landonmaynard/nighthawk/docs/BUDGET.md

# Budget & Funding

## Overview

Nighthawk is an independent engineering project that I'm developing and funding myself. I've already invested my own time, money, and equipment into its design, simulations, and electronics development.

As a high school student, covering the remaining costs on my own is difficult. I'm seeking support to continue the project and get real experience with mechanical design, electronics, and software.

My goal is to have funding by **December 31, 2026**, so it will be possible to complete by **Spring 2027**

## Funding Goal

**Target: $800**

| Funding Status | Amount |
|---|---:|
| Funding Goal | $800.00 |
| Contributions Received | $800.00 |
| Remaining Goal | $0.00 |
| Progress | 100% |

**FUNDED!**

## Cost Breakdown

My current bill of materials includes the following estimated costs:

| Category | Estimated Cost |
|---|---:|
| Airframe & Structure | $148.69 |
| Propulsion & Retention | $189.06 |
| Recovery & Rigging | $88.66 |
| Avionics & Telemetry | $154.90 |
| Consumables | $84.60 |
| Taxes & Shipping | $145.85 |
| **Total Estimated Cost** | **$811.76** |

These figures include approximately **$180.48 in equipment I have already bought**, leaving $631.28 in currently listed expenses.

My $800 funding goal provides some flexibility for changing prices, unexpected expenses, and further engineering development.

### Detailed Bill of Materials

The complete spreadsheet contains individual components, quantities, estimated prices, suppliers, and shipping costs.

**[View the Nighthawk Bill of Materials](BOM.xlsx)**

The spreadsheet includes two sheets:

- **BOM:** Itemized components, quantities, and estimated costs.
- **Shipping:** Supplier-specific shipping estimates and supporting information.

Prices and product selections can change, and I'll keep the spreadsheet updated as the project progresses.

## Sponsorship & Support

With permission, I'd like to recognize sponsors in this repository, including the main README and this budget. Also, on individual cases I can put a logo on the final rocket. Contributions of any size are greatly appreciated.

### Sponsors

- **$400 - Vern Knowles and Multitronix**
- **$250 - Dmitriy Yavid**
- **$100 - Aaron Clarke and Embedded Systems Consulting**
- **$50 - Robert Yarbrough**
- **Richard Grimmett** — Avionics sensors
- **[b2 Rocketry Co.](https://b2rocketry.com)** — Recovery parachute

## Additional Funding

I'm striving to make the most out of every dollar donated, putting it towards materials and electronics, with no funding towards any work I do.

I'll continue to update this and the main page as changes are made, and the current total.

---

*Last updated: November 10 2026*
