landonmaynard/nighthawk/cad/ONSHAPE.md

https://cad.onshape.com/documents/133a6bdae2082b7afaaeb0c3/w/fbf40f275b5edf98284b4e3f/e/2c8e62942e56a1cf9c46fe07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
