landonmaynard/nighthawk/media/images/imu-demo.jpg

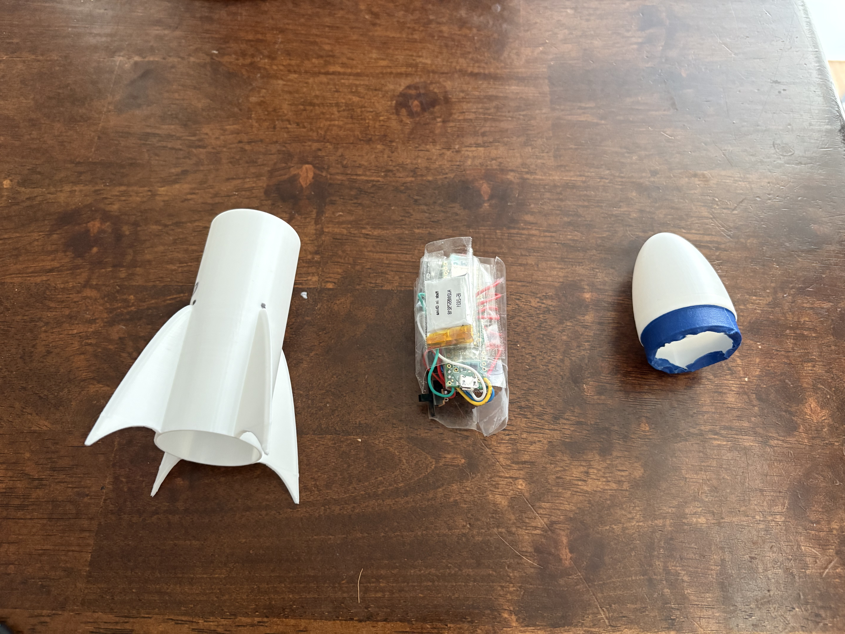
media/images/imu-demo.jpg
