landonmaynard/nighthawk/media/images/imu-progress.jpg

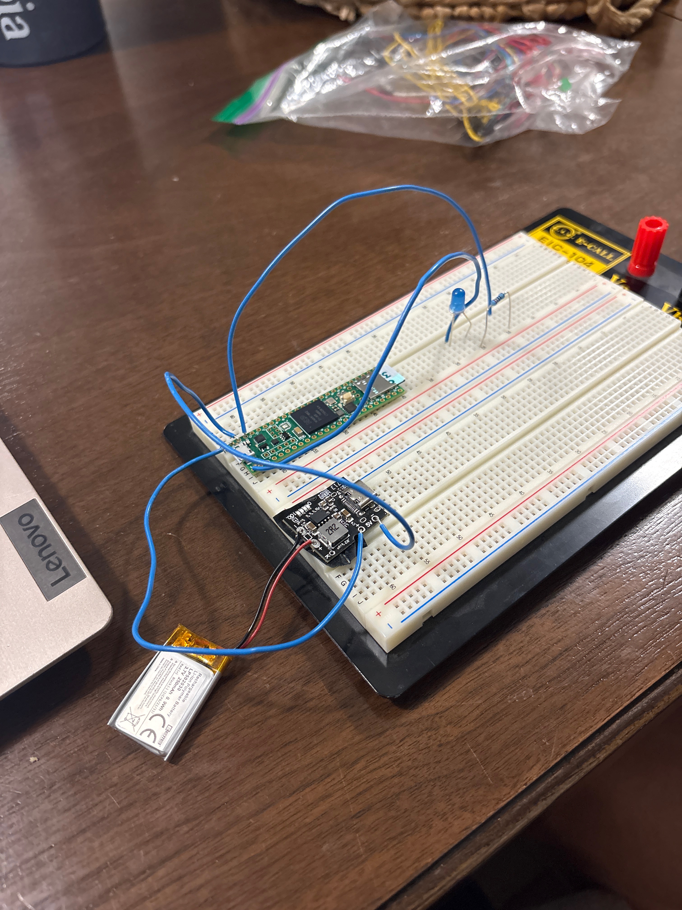
media/images/imu-progress.jpg
