landonmaynard/nighthawk/docs/BOM.xlsx

Sheet: BOM
Item | Subsystem | Part / Specification | Supplier | Purchase Qty | Unit Cost $ | Total Cost $ | Build / Ownership | Source / Selection Status
Booster Blue Tube | Airframe & Structure | 3" (75mm) x .062 wall x 48" Airframe | Always Ready Rocketry | 1 | 36.96 | 36.96 | Commercial | https://alwaysreadyrocketry.com/product/1-15-29mm-x-062-wall-x-48-airframe-mmt/
e-Bay Blue Tube | Airframe & Structure | 3" (75mm) x .062 wall x 24" MMT | Always Ready Rocketry | 1 | 20.48 | 20.48 | Commercial | https://alwaysreadyrocketry.com/product/1-15-29mm-x-062-wall-x-48-airframe-mmt/
AeroTech Motor | Propulsion & Retention | AeroTech I500T-14A 38mm x 356mm Single Use DMS 1-Motor Kit - 095014; already purchased, no new shipping | AeroTech | 1 | 129.99 | 129.99 | Owned; grant value retained | https://aerotech-rocketry.com/products/product_b8bb226e-67ff-3fc3-2803-c4bade36e0b8
Fin Stock | Airframe & Structure | LOC 18PLY: 1/8 in. 3-ply Baltic birch, 6 x 12 in. sheets; four sheets equal original 12 x 24 in. area. PROVISIONAL: each complete fin/tab must fit one sheet; confirm cutting layout before purchase. | LOC Precision | 4 | 5.62 | 22.48 | Cut / TTW fins | https://locprecision.com/products/loc-plywood?variant=39778639413439
Nose Cone | Airframe & Structure | LOC PNC-3.00, 3.0 in. (75mm) plastic nose cone; verify shoulder fit before ordering | LOC Precision | 1 | 24.47 | 24.47 | Commercial | https://locprecision.com/products/nose-cones?variant=39778657304767
Blue Tube Coupler | Airframe & Structure | 3" (75mm) x .062 wall x 8" | Always Ready Rocketry | 1 | 9.00 | 9.00 | Commercial | https://alwaysreadyrocketry.com/product/1-15-29mm-x-062-wall-x-8-coupler/
Centering Ring / Bulkhead Baltic Birch | Airframe & Structure | LOC 25PLY: 1/4 in. 5-ply Baltic birch, 6 x 12 in. sheets. Two sheets for SIX ring/bulkhead pieces TOTAL, including stepped bulkheads; confirm final cutting layout, kerf and measured tube fits before purchase. | LOC Precision | 2 | 8.37 | 16.74 | Cut rings / bulkheads | https://locprecision.com/products/loc-plywood?variant=39778639380671
Rail Buttons Set | Airframe & Structure | AeroPack standard 1010 Delrin rail button pair, Apogee #13060; mounting screws included | Apogee Components | 1 | 5.58 | 5.58 | Commercial | https://www.apogeerockets.com/Building_Supplies/Rail_Buttons/1in_1010_Rail_Button_Standard
Motor Mount Tube | Propulsion & Retention | 1.52" (38mm) x .062 wall x 16" MMT | Always Ready Rocketry | 1 | 7.95 | 7.95 | Commercial | https://alwaysreadyrocketry.com/product/1-15-29mm-x-062-wall-x-48-airframe-mmt/
Motor Retainer | Propulsion & Retention | AeroPack RA38L 38mm L threaded retainer set, Apogee #24062; 1.630 in. ID for Blue Tube mount; verify actual tube OD | Apogee Components | 1 | 30.63 | 30.63 | Commercial | https://www.apogeerockets.com/Building_Supplies/Motor_Retainers_Hooks/Screw-on_Retainers_38mm/38mm_AeroPack_Retainer_L
Delay Drilling Tool | Propulsion & Retention | AeroTech DMS Universal Delay Drilling Tool - UDDT | AeroTech | 1 | 20.49 | 20.49 | Commercial | https://aerotech-rocketry.com/products/product_d208be9f-32da-778d-77e9-093c84bb0508
42" Parachute | Recovery & Rigging | LOC/PRECISION Parachutes LP-42 | LOC Precision | 1 | 34.81 | 34.81 | Commercial | https://locprecision.com/products/locprecision-parachutes?variant=39778658451647
Shock Cord | Recovery & Rigging | LOC TN-25: 25 ft x 5/8 in. tubular nylon, sewn end loops, published 2200 lb tensile rating; final recovery-load/attachment check pending | LOC Precision | 1 | 22.70 | 22.70 | Commercial | https://locprecision.com/products/shock-cords?variant=39778657665215
Flame Blanket | Recovery & Rigging | LOC/PRECISION Flame Resistant Blankets FRB-S | LOC Precision | 1 | 8.67 | 8.67 | Commercial | https://locprecision.com/products/locprecision-flame-resistant-blankets?variant=39778640494783
MMT Parachute Eye Bolts (2-pack) | Recovery & Rigging | 1/4 in.-20 x 2 in. Zinc Eye Bolt (2-Pack); quantity is packs purchased; recovery load suitability still requires review | Home Depot | 1 | 1.57 | 1.57 | Commercial | https://www.homedepot.com/p/Everbilt-1-4-in-20-x-2-in-Zinc-Eye-Bolt-2-Pack-824301/314745414
e-Bay Parachute Eye Nuts (2-pack) | Recovery & Rigging | 1/4" Round Lifting Eye Nut (2/pk); quantity is packs purchased | Apogee Components | 1 | 14.43 | 14.43 | Commercial | https://www.apogeerockets.com/Building-Supplies/Misc-Hardware/Round-Lifting-Eye-Nut-2-pk
Machine Screws (Nose Shoulder Mounting) | Recovery & Rigging | Hillman #4 - 40 x 1-in Phillips/Slotted combination -Drive Machine screws 10 -Count; quantity is 10-count packs purchased; quantity is 10-count packs purchased; quantity is 10-count packs purchased | Lowe's | 1 | 1.98 | 1.98 | Commercial | https://www.lowes.com/pd/Hillman-4-40-x-1-in-Phillips-Slotted-Combination-Drive-Machine-Screws-10-Count/3036647
Custom PCB | Avionics & Telemetry | ESTIMATE: 50 x 100 mm, 2-layer FR-4, 1.6 mm; fit TBD; $20 batch allowance includes shipping, not a quote | JLCPCB | 5 | 4.00 | 20.00 | Custom (Fab) | https://jlcpcb.com/help/article/how-do-i-place-an-order
Microcontroller | Avionics & Telemetry | Teensy 4.1; already purchased, no new shipping | SparkFun | 1 | 31.50 | 31.50 | Owned; grant value retained | https://www.sparkfun.com/teensy-4-1.html
6-DOF IMU | Avionics & Telemetry | Adafruit ISM330DHCX 6-DoF IMU breakout #4502 | Adafruit | 1 | 19.95 | 19.95 | Commercial | https://www.adafruit.com/product/4502
Barometer & Thermometer | Avionics & Telemetry | Adafruit BMP388 - Precision Barometric Pressure and Altimeter - STEMMA QT | Adafruit | 1 | 9.95 | 9.95 | Commercial | https://www.adafruit.com/product/3966
Magnetometer | Avionics & Telemetry | Adafruit LIS2MDL Triple-axis Magnetometer #4488 | Adafruit | 1 | 7.95 | 7.95 | Commercial | https://www.adafruit.com/product/4488
GPS | Avionics & Telemetry | NEO-6M GPS Module with antenna | ProtoSupplies | 1 | 10.95 | 10.95 | Commercial | https://protosupplies.com/product/neo-6m-gps-module/
ELRS Receiver | Avionics & Telemetry | RP1 V2 ExpressLRS 2.4ghz Nano Receiver; already purchased, no new shipping | RadioMaster | 1 | 18.99 | 18.99 | Owned; grant value retained | https://radiomasterrc.com/products/rp1-expresslrs-2-4ghz-nano-receiver
Voltage & Current Monitor | Avionics & Telemetry | INA219 DC Current Measurement Module (MOD-72) | ProtoSupplies | 1 | 2.59 | 2.59 | Commercial | https://protosupplies.com/product/ina219-dc-current-measurement-module/
Flight Battery | Avionics & Telemetry | BadAss 45C 1000mAh 2S LiPo (BA-L45C-1000-2S), XT30 | Innov8tive Designs | 1 | 11.99 | 11.99 | Commercial | https://innov8tivedesigns.com/badass-45c-1000mah-2s-lipo-battery.html
Voltage Regulator | Avionics & Telemetry | MPM3610 5V 1.2A Buck Converter Breakout #4739 | Adafruit | 1 | 6.95 | 6.95 | Commercial | https://www.adafruit.com/product/4739
Power Switch (2-pack) | Avionics & Telemetry | Miniature Toggle Switch DPDT ON-OFF-ON (SWT-11); one used, one spare | ProtoSupplies | 1 | 1.19 | 1.19 | Commercial | https://protosupplies.com/product/miniature-toggle-switch-dpdt/
Locator Alarm | Avionics & Telemetry | Large Piezo Alarm - 16 Tone (COM-13939) | SparkFun | 1 | 7.95 | 7.95 | Commercial | https://www.sparkfun.com/large-piezo-alarm-16-tone.html
Alarm Driver Transistor (10-pack) | Avionics & Telemetry | 2N3904 NPN TO-92 (XTR-4); one used, nine spare; resistors already owned | ProtoSupplies | 1 | 1.95 | 1.95 | Commercial | https://protosupplies.com/product/2n3904/
XT30 Connector Set | Avionics & Telemetry | XT30-2M-2F; two male and two female connectors | Innov8tive Designs | 1 | 2.99 | 2.99 | Commercial | https://innov8tivedesigns.com/xt30-connector-set-2-male-2-female.html
Structural Epoxy | Consumables | BSI Slow-Cure 30-minute epoxy, 9 oz combined resin and hardener (BSEPY-309 / BSI-206) | LOC Precision | 1 | 23.61 | 23.61 | Commercial | https://locprecision.com/products/epoxy?variant=39778639872191
PETG Filament | Consumables | BUDGET ONLY: 1 kg PETG, 1.75 mm, $20 allowance. Brand, seller and printer compatibility unselected; separate $8 shipping allowance retained. | Unselected supplier | 1 | 20.00 | 20.00 | Commercial | Not selected; budget allowance, not a product quote
Paint & Primer | Consumables | BUDGET ONLY: compatible primer and spray paint; $25 combined allowance. Planned local pickup; exact products, color and coverage not selected. | Home Depot | 1 | 25.00 | 25.00 | Commercial | Not selected; budget allowance, not a product quote
Recovery Quick Links | Recovery & Rigging | LOC CEC-2: 3/16 in. zinc quick link, published 660 lb rating; verify opening fit and final recovery loads | LOC Precision | 2 | 2.25 | 4.50 | Commercial | https://locprecision.com/products/chain-eye-connector?variant=39778639642815
E-Bay Threaded Rod | Airframe & Structure | Everbilt 1/4 in.-20 x 36 in. zinc-plated threaded rod #17320; cut two lengths, final length TBD | Home Depot | 1 | 2.98 | 2.98 | Commercial / cut to length | https://www.homedepot.com/p/100338099
Miscellaneous Bolts / Hardware | Airframe & Structure | BUDGET ONLY: $10 for assorted bolts, washers and nuts; planned local pickup; exact sizes and quantities depend on final assembly. | Home Depot | 1 | 10.00 | 10.00 | Commercial | Not selected; budget allowance, not a product quote
Tube Sanding Sealer | Consumables | ProLuxe 1 qt sanding sealer PLX015/04; Ace item 11268; listed oil-based alkyd lacquer; confirm Blue Tube and paint compatibility, local stock | Ace Hardware | 1 | 15.99 | 15.99 | Commercial | https://www.acehardware.com/p/11268
Estimated Sales Tax | Tax & Shipping | 6% budget allowance on listed item values, including already-owned grant values and bundled PCB allowance. Reconcile receipts; separate shipping excluded. | Idaho | 1 | 39.95 | 39.95 | Budget estimate | https://tax.idaho.gov/taxes/sales-use/online-guide/
Estimated Shipping | Tax & Shipping | ZIP 83274. Shipping tab distinguishes published rates, pickup assumptions and unquoted allowances; actual quotes remain pending. | Multiple suppliers | 1 | 105.90 | 105.90 | Budget estimate | See Shipping tab for supplier policies and quote status
BOM TOTAL | Budget Total | Includes owned-item grant values, 6% estimated tax and shipping budgets. Product choices retained; no purchase placed. | All listed suppliers | 1 | 811.76 | 811.76 | Calculated budget | Calculated from item, tax and shipping rows above

Sheet: Shipping
Supplier | New Order Subtotal $ | Shipping Budget $ | Basis / Outstanding Quote — ZIP 83274 — checked 2026-10-21 | Source
Always Ready Rocketry | 74.39 | 24.95 | PUBLISHED BASE ESTIMATE: $58.01-$120 order tier; three tubes and one coupler total $74.39. 48-inch tube sets box length. Boxed weight/size may increase final charge; request seller invoice. | https://alwaysreadyrocketry.com/shipping/
AeroTech | 20.49 | 10.00 | UNQUOTED allowance retained: UDDT tool only ($20.49). I500T already owned; no new motor freight or hazmat. Tool page calculates shipping at checkout; no public rate found. | https://aerotech-rocketry.com/products/product_d208be9f-32da-778d-77e9-093c84bb0508
Apogee Components | 50.64 | 12.00 | UNQUOTED allowance retained: rail buttons, RA38L retainer and eye-nut pack. Cart estimates packaging and may be revised after packing; no fixed public rate found. | https://www.apogeerockets.com/Shipping_Info
LOC Precision | 157.98 | 15.00 | UNQUOTED allowance retained: six plywood sheets total (4 thin + 2 thick), nose cone, parachute, harness, blanket, epoxy and two quick links. Ships USPS/UPS; checkout/packed-box quote required. | https://locprecision.com/policies/shipping-policy
SparkFun | 7.95 | 8.00 | UNQUOTED allowance retained: COM-13939 alarm only ($7.95). Teensy owned, excluded from new-order subtotal. Below $100 qualifying free-shipping threshold; cart quote required. | https://www.sparkfun.com/support
Adafruit | 44.80 | 10.00 | UNQUOTED allowance retained: ISM330DHCX, BMP388, LIS2MDL and MPM3610, $44.80 combined. USPS Ground Advantage allowed below $200; price requires cart/address. No batteries in this order. | https://www.adafruit.com/shipping
ProtoSupplies | 16.68 | 7.95 | PUBLISHED RATE: USPS Ground Advantage $7.95 for orders under $175; this order $16.68. Shipping page takes precedence over FAQ still showing $6.95. Not a checkout quote. | https://protosupplies.com/shipping-and-returns/
Innov8tive Designs | 14.98 | 10.00 | UNQUOTED allowance retained: 1000mAh 2S LiPo + XT30 set, $14.98. Public First Class Parcel flat rate $6.99 is not confirmed for a standalone LiPo order; retain $10 until battery-eligible cart service is quoted. | https://innov8tivedesigns.com/about-us/shipping-information.html
Unselected supplier | 20.00 | 8.00 | UNQUOTED allowance retained: PETG seller not selected. $20 material plus $8 delivery budget; cannot quote shipping until product/seller selected. | Not applicable; PETG supplier not selected
Home Depot | 39.55 | 0.00 | PICKUP ASSUMPTION: eye-bolt pack, threaded rod, $25 paint/primer allowance and $10 miscellaneous hardware allowance. Eligible store pickup is free; exact local stock and unselected products not verified. | https://www.homedepot.com/c/pick_up_in_store
Lowe's | 1.98 | 0.00 | PICKUP ASSUMPTION: one 10-count screw pack. Store pickup has no added charge when eligible; selected-store stock not verified. | https://www.lowes.com/l/help/store-pickup
Ace Hardware | 15.99 | 0.00 | PICKUP ASSUMPTION: ProLuxe sanding sealer. Free store pickup/warehouse-to-store where eligible; availability of this specific sealer locally not verified. | https://www.acehardware.com/customer-service-center/pickup-delivery-shipping
RadioMaster | 0.00 | 0.00 | ALREADY OWNED: RP1 receiver value stays in grant BOM; no new order or shipping. Ranger Micro remains excluded as requested. | https://radiomasterrc.com/products/rp1-expresslrs-2-4ghz-nano-receiver
JLCPCB | 20.00 | 0.00 | INCLUDED IN ALLOWANCE: $20 PCB batch budget already includes shipping; zero here prevents double counting. Not free shipping. Board design, weight, service, import charges and final checkout total still unquoted. | https://jlcpcb.com/help/article/how-much-does-shipping-cost
Total | 485.43 | 105.90 | Published rate/base estimates plus UNQUOTED allowances. No checkout shipping quotes obtained: remote browser blocked store access. Taxes excluded here. | Sources above; selected products and quantities are on BOM tab
