landonmaynard/nighthawk/cad/nighthawk.step

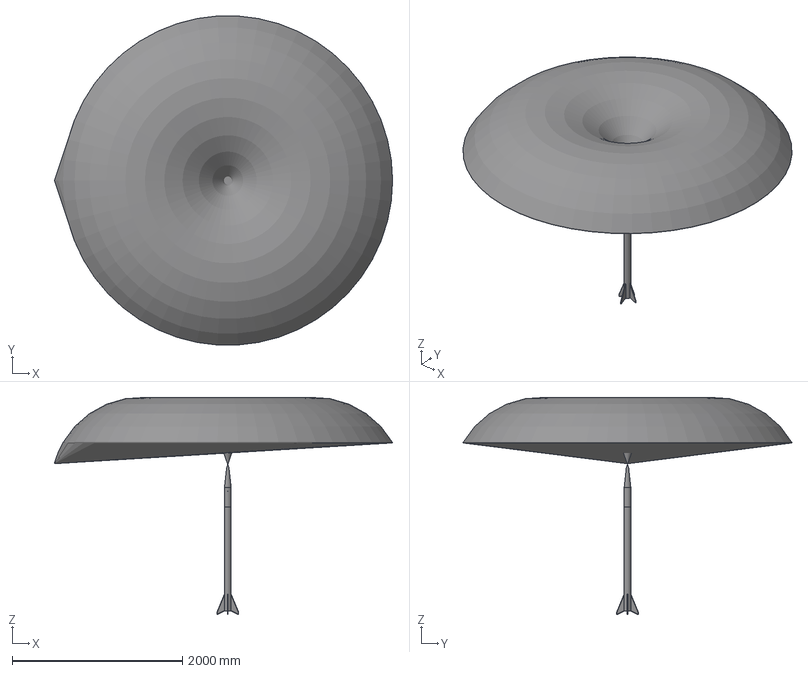
[picture p5: CAD file, 2026-10-31]
cad/nighthawk.step
3968.4 x 3859.9 x 2548.0 mm
HW-661 v4 x 38
BT eBay
Adafruit_ISM330DHXC.step-1/C_0805_2012Metric.step-2/SOLID.step-1-soli d1
Fin B
Adafruit_ISM330DHXC.step-1/SM04B-SRSS-TB(LF)(SN)--3DModel-STEP-56544. step-2/COMPOUND.step-1-solid2
Fin A
Adafruit_ISM330DHXC.step-1/QFN_DHCXTR_STM.step-1/COMPOUND-1.step-1-so lid4
Adafruit_ISM330DHXC.step-1/QFN_DHCXTR_STM.step-1/COMPOUND-1.step-1-so lid2
Fin C
Adafruit_ISM330DHXC.step-1/SM04B-SRSS-TB(LF)(SN)--3DModel-STEP-56544. step-2/COMPOUND.step-1-solid1
Adafruit_ISM330DHXC.step-1/QFN_DHCXTR_STM.step-1/COMPOUND-1.step-1-so lid6
Adafruit_ISM330DHXC.step-1/SM04B-SRSS-TB(LF)(SN)--3DModel-STEP-56544. step-2/COMPOUND.step-1-solid7
Aft Centering Ring
Adafruit_ISM330DHXC.step-1/LED_0603_1608Metric.step-1/SOLID-0.step-1- solid1
Cut-Extrude1 x 3
Move Face1
Booster Tube
Adafruit_ISM330DHXC.step-1/QFN_DHCXTR_STM.step-1/COMPOUND-1.step-1-so lid3
Rod B
PCB
Adafruit_ISM330DHXC.step-1/SM04B-SRSS-TB(LF)(SN)--3DModel-STEP-56544. step-1/COMPOUND.step-1-solid4
Inner Bulkhead
MMT
Fore Centering Ring
Eye B
Adafruit_ISM330DHXC.step-1/C_0805_2012Metric.step-1/SOLID.step-1-soli d1
Rod A
Adafruit_ISM330DHXC.step-1/SM04B-SRSS-TB(LF)(SN)--3DModel-STEP-56544. step-1/COMPOUND.step-1-solid1
Center Centering Ring
Adafruit_ISM330DHXC.step-1/SM04B-SRSS-TB(LF)(SN)--3DModel-STEP-56544. step-1/COMPOUND.step-1-solid5
Adafruit_ISM330DHXC.step-1/QFN_DHCXTR_STM.step-1/COMPOUND-1.step-1-so lid15
Adafruit_ISM330DHXC.step-1/SM04B-SRSS-TB(LF)(SN)--3DModel-STEP-56544. step-1/COMPOUND.step-1-solid3
Adafruit_ISM330DHXC.step-1/SM04B-SRSS-TB(LF)(SN)--3DModel-STEP-56544. step-2/COMPOUND.step-1-solid4
Fin D
Outer Bulkhead
Adafruit_ISM330DHXC.step-1/SM04B-SRSS-TB(LF)(SN)--3DModel-STEP-56544. step-1/COMPOUND.step-1-solid7
Adafruit_ISM330DHXC.step-1/SM04B-SRSS-TB(LF)(SN)--3DModel-STEP-56544. step-2/COMPOUND.step-1-solid3
Adafruit_ISM330DHXC.step-1/QFN_DHCXTR_STM.step-1/COMPOUND-1.step-1-so lid5
CIRCUIT BOARD,TEENSY 4.1-1-solid1
Adafruit_ISM330DHXC.step-1/QFN_DHCXTR_STM.step-1/COMPOUND-1.step-1-so lid14
Adafruit_ISM330DHXC.step-1/QFN_DHCXTR_STM.step-1/COMPOUND-1.step-1-so lid12
Adafruit_ISM330DHXC.step-1/QFN_DHCXTR_STM.step-1/COMPOUND-1.step-1-so lid10
Adafruit_ISM330DHXC.step-1/QFN_DHCXTR_STM.step-1/COMPOUND-1.step-1-so lid13
Adafruit_ISM330DHXC.step-1/QFN_DHCXTR_STM.step-1/COMPOUND-1.step-1-so lid7
Shoulder
Slide
Adafruit_ISM330DHXC.step-1/SM04B-SRSS-TB(LF)(SN)--3DModel-STEP-56544. step-1/COMPOUND.step-1-solid2
Eye A
Adafruit_ISM330DHXC.step-1/SM04B-SRSS-TB(LF)(SN)--3DModel-STEP-56544. step-1/COMPOUND.step-1-solid6
Adafruit_ISM330DHXC.step-1/QFN_DHCXTR_STM.step-1/COMPOUND-1.step-1-so lid11
Adafruit_ISM330DHXC.step-1/QFN_DHCXTR_STM.step-1/COMPOUND-1.step-1-so lid8
Adafruit_ISM330DHXC.step-1/QFN_DHCXTR_STM.step-1/COMPOUND-1.step-1-so lid1
Adafruit_ISM330DHXC.step-1/SM04B-SRSS-TB(LF)(SN)--3DModel-STEP-56544. step-2/COMPOUND.step-1-solid6
Adafruit_ISM330DHXC.step-1/QFN_DHCXTR_STM.step-1/COMPOUND-1.step-1-so lid9
Adafruit_ISM330DHXC.step-1/QFN_DHCXTR_STM.step-1/COMPOUND-1.step-1-so lid16
Adafruit_ISM330DHXC.step-1/SM04B-SRSS-TB(LF)(SN)--3DModel-STEP-56544. step-2/COMPOUND.step-1-solid5
