landonmaynard/nighthawk/demo/Python/imuDemoCode/demoRocket.stl

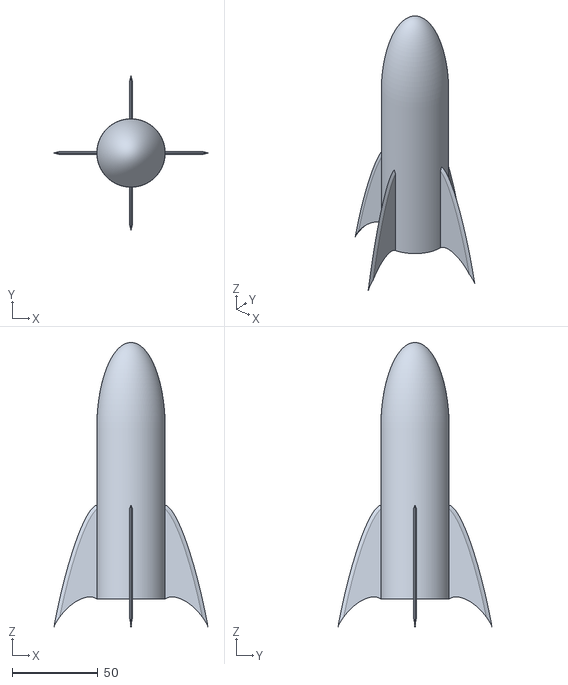
[picture p6: CAD file, 2026-11-03]
demo/Python/imuDemoCode/demoRocket.stl
90.0 x 90.0 x 166.0
