landonmaynard/nighthawk/(commit log)

2026-10-31 Revise introduction in README.md
    Updated personal introduction for clarity and flow.
2026-11-01 Revise Nighthawk CAD and simulation images
    Updated images and descriptions for Nighthawk project.
2026-11-01 Fix image paths in README.md
    Updated image paths in README for CAD and simulation.
2026-11-03 Change IMU Demonstration to IMU Demo
    Updated the title of the IMU demonstration in the README.
2026-11-03 Update IMU Demo image link in README
2026-11-03 Update BOM link in BUDGET.md
2026-11-03 Add development journal with project progress
    Document the development process and progress of the project, including initial concepts, CAD design, simulation, and electronics/software demo.
2026-11-03 Add development roadmap for Nighthawk project
    This document outlines the development roadmap for the Nighthawk project, detailing mechanical design, electronics, software, and funding tracks. It includes a flowchart and project targets with milestones and completion dates.
2026-11-13 Add initial project structure and configuration files; remove unused Python files
    [demoRocket.stl]
2026-11-13 Add initial files for sonar module including README, .gitignore, requirements, and test script
2026-11-14 Update project documentation and codebase for Nighthawk
    - Updated README.md to reflect new funding status and contributions.
    - Added main.cpp for Arduino implementation of IMU data handling.
    - Created platformio.ini for project configuration and dependencies.
    - Added demoRocket.stl for 3D model representation.
    - Implemented imuDemo.py for real-time data visualization and processing.
    - Added imuDemoLegacy.py for legacy data handling.
    - Created imuSim.py for simulated IMU data generation.
    - Revised BUDGET.md to show full funding and updated cost breakdown.
    - Updated ROADMAP.md to reflect completed funding and preparation tasks.
    [demoRocket.stl]
